aman32hhjbb/Ball-Beam-System/Balance_Ball_Beam_Report.pdf

## EE 396 Design Project Ball Beam System

Mohit Rana (200102054)
Aman Kumar (200102007)

Objective :

To design a control system for a ball and beam apparatus that can maintain the position of the ball at a specified location on the beam, despite of any change in the position of the ball along the beam.

Material Required :

1. Arduino Uno
2. Servo Motor
3. Two Ultrasonic Range Finder
4. Small Bread Board
5. Jumper Wire
6. Plywood
7. Plywood Paint
8. Pencil
9. Sandpaper
10. Hacksaw Blade
11. Ball
12. 9V Adapter

Introduction :

The ball and beam system is a classic example of a control system that is used to demonstrate various concepts in control theory. The system consists of a ball that rolls on an wooden beam, and a control mechanism that maintains the position of the ball at a specific location on the beam. The control mechanism can be implemented using various algorithms, including proportional, integral, derivative (PID) control.
In this project, we aimed to design and control a ball and beam system using a PID controller. The objective was to develop a system that could maintain the position of the ball at a specific location on the beam, despite disturbances or changes in the system parameters. We used a microcontroller, servo motor, ultrasonic sensors and other components to design the system.

Supervisor :
Prof. Chayan Bhawal

Physical Setup :

To create the physical ball beam system, we will utilize plywood as the primary material. The plywood pieces will be fastened together using nails to form permanent joints. The dimensions of the ball beam setup are illustrated in the accompanying figure.

1. The length of the beam on which the ball is resting is 45 cm. The width of top beam is less than the width of the lower beam. This ensures that that the top beam does not touch the bottom beam when it is at an inclined position.
2. Servo-motor is placed in such a way that the shaft connected to the top beam is almost at right-angles to ground when the beam is at balanced position.
3. The position of both the ultra-sonic sensors is set in such a way that that the transmitted waves from the sensor hits the center of the ball because wrong sensor placement can lead to erroneous readings which will make it difficult for us to tune the controller parameters.
4. To ensure the system operates smoothly and accurately, it is crucial to prevent any horizontal movement of the top beam. To achieve this, we will be using bearings to hold the spindle in place, while a pencil will be used as the spindle itself to prevent any horizontal movement of the top beam. We will fix the top beam firmly to the spindle to prevent unwanted vibrations that could interfere with tuning the controller parameters accurately. The combination of the bearing and pencil will ensure that the top beam is securely held in place, and we can expect the ball beam system to operate smoothly and accurately during our experiment.
5. To prevent the ball from colliding with the sensor, we will be installing a small barrier in front of the sensor. This barrier will ensure that the ball remains within the boundaries of the ball beam system and does not interfere with the accuracy of the sensor measurements.

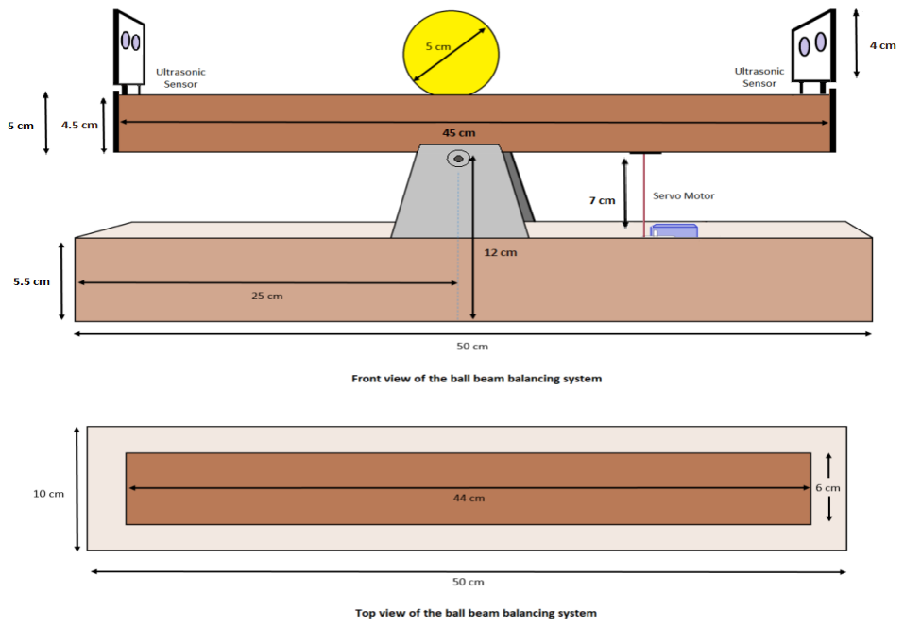
[picture p1: figure]

Modeling and Dynamics
The ball and beam system may be broken down into smaller systems, and when these systems work together, the ball appears to be moving smoothly on the beam and vice versa so knowing the contributions and coordination of each component becomes crucial from the perspective of mathematical analysis hence the system's equation of motion and transfer function must be developed from the perspective of control and the same is implemented below.

Transfer function of a Ball Beam System
The ratio of the output and input Laplace transforms is used to define the transfer function of any system. Newtonian mechanics can be used to get the equation for the motion of the ball on the beam. Combining the transfer functions of the following subsystems will yield the transfer function:
(i) Beam tilt to ball position
(ii) Input voltage of the motor to its angle of rotation and tilt angle of the beam. Think about Fig. 1 The ball on the beam is moving both in translation and in rotation. Now, assuming that the ball's translational acceleration is xሷand that force F is given by

Ftx= mxሷ= m

d

2x
dt²
, | (1)
Wℎere m is tℎe mass of tℎe Ball.

Tℎe rotational torque T of tℎe Ball = J

dw
dt
| Wℎere w is tℎe angular velocity.
J = Moment of Inertia of tℎe Ball

Rotaional Force Frx =

T
R

=

J
R²

xሷ

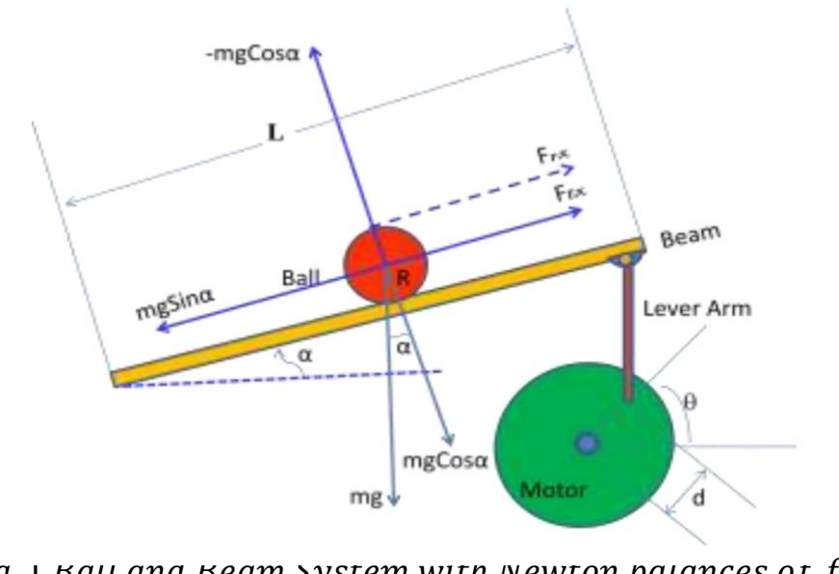
[picture p2: figure]

Fig. 1 Ball and Beam System witℎ Newton balances of forces

As shown in Fig. 1 we have Frx + Ftx = −mgsignα

J
R² + m xሷ= −mgsinα | (2)

The geometry of the lever arm section, as depicted in Fig. 2, can be used to determine the relationship between θ and α. The lever mechanism, which consists of lever arms SP = A and OS = d, is attached to the beam at P. Assume that the motor arm OS goes to T and the beam's end P moves to Q in such a way that ∠SOT = θ and ∠PO1Q = α.
OX = d cosθ; TX = dsinθ;
XS = OS − OX = d 1 − cosθ
O1M = L cosα; QM = L sinα; MP = L 1 − cosα TN = A sinβ; QN = A cosβ; MN = A cosβ − L sinα TX = PS − PG = MZ − MN
⇒ d sinθ = A − A cosβ + L sinα
⇒ d sinθ − A 1 − cosβ − L sinα = 0 ⇒ L sinα = d sinθ − A(1 − cos β) ⇒ α = arc sin d
L

sinθ −

A
L
1 − cosβ | (3)

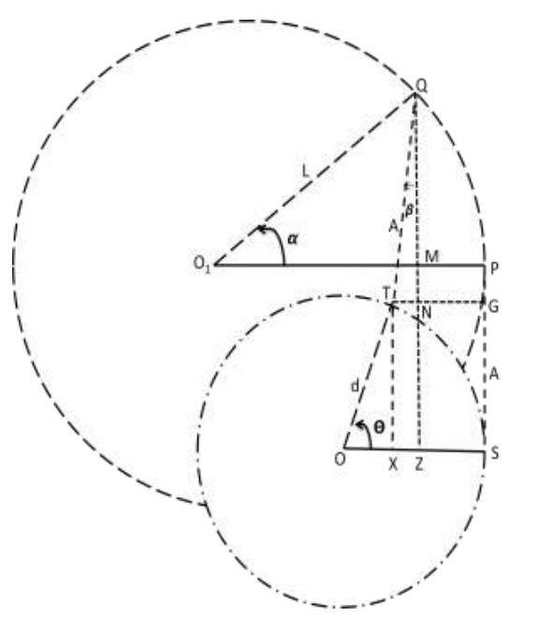
[picture p3: figure]

Fig. 2 Relation between Motor angle and Beam anle

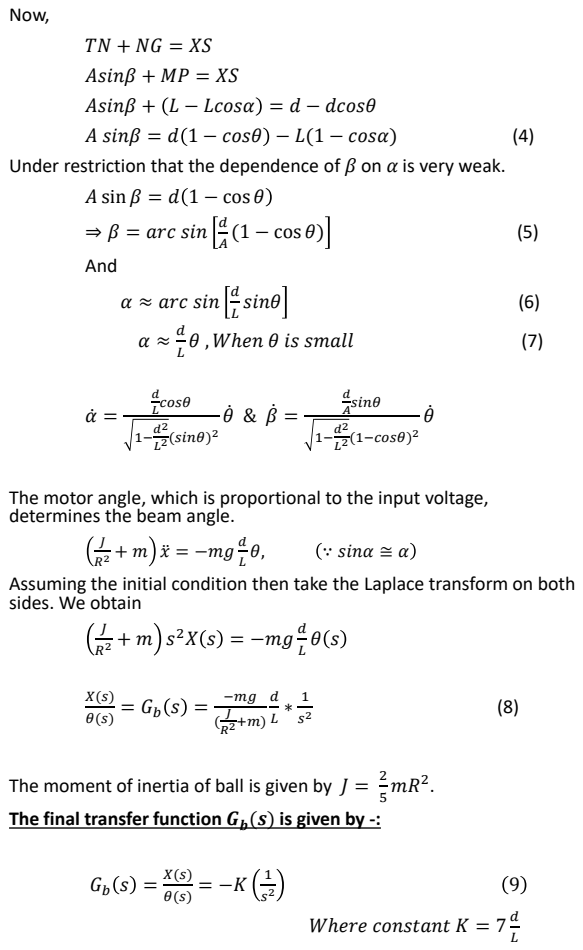
[picture p4: page 5]
Now,; A sinβ = d 1 − cosθ − L(1 − cosα); A sin β = d 1 − cos θ; ⇒ β = arc sin; (1 − cos θ); And; α ≈ arc sin; sinθ; θ , Wℎen θ is small; cosθ; (sinθ); (1−cosθ); ∵ sinα ≅ α; Wℎere constant K = 7

Asinβ + MP = XS
Asinβ + L − Lcosα = d − dcosθ

Under restriction that the dependence of β on α is very weak.

The motor angle, which is proportional to the input voltage,
determines the beam angle.

Assuming the initial condition then take the Laplace transform on both
sides. We obtain

The moment of inertia of ball is given by J =
The final transfer function Gb(s) is given by -:

Transfer Function of Servo Motor
The applied input voltage Ea(s) to the DC servomotor determines the angle of rotation of the motor. The motor is connected to the pivot of the beam which determines the tilt of the beam, which in turn regulates the velocity of the ball on the beam thus motor's transfer function Gm(s) is obtained as follows.
We have used DC servomotor whose armature controller is DC motor model. The armature current in the armature regulated DC motor which regulates the shaft position and speed while maintaining a constant field current.
Fig. 3 depicts the circuit diagram of an armature-controlled DC motor.

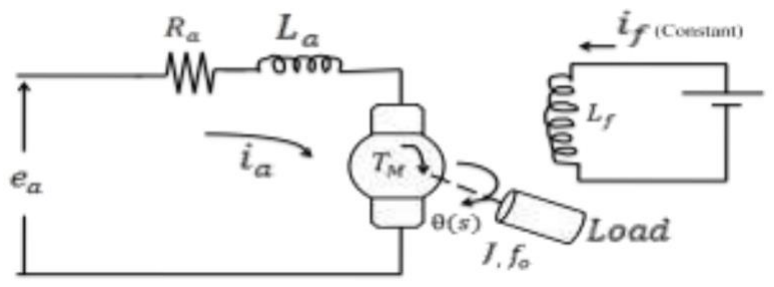
[picture p5: figure]

Fig. 3 Armature controlled DC Motor

The torque TM produced by the motor is proportional to the airgap flux φ and the armature current, and it can be determined by the applied armature voltage ea setup armature current ia in the armature circuit.

If we apply KVL in armature circuit gives we will get,

Here eb is the back emf generated by the armature's spin in the magnetic field.

where kb is the back e.m.f. constant

Parameters shown in the Fig.3.are, Ra = Resistance of armature
La = Inductance of armature
TM = Torque produced by motor (Nm )
θ = angular displacement of motor sℎaft

J = ( Jm + JL) =Equivalent moment of inertia of load and motor

f0= Viscous friction coefficent of motor and load acting on motor sℎaft

TM = k1 ∅ ia = k1kf if ia
= k1kfif ia = k1kfif ia = kTia where k1 = constant; kf = constant kT is tℎe motor constant

La

dia
dt + Raia + eb = ea (10)

eb = kb

dθ
dt
, | )11(

The motor's developed torque, denoted as TM, is utilized for rotating a load while resisting viscous forces. Hence, the torque equation can be expressed as follows:

J

d

2θ
dt² + f0

dθ
dt
= TM = kTia | 12

Taking initial condition to be zero and obtaining the Laplace transform of equation (10), (11) and (12), we get

(13)
Now, we used this equation to represent block diagram of motor as shown in Fig.4.

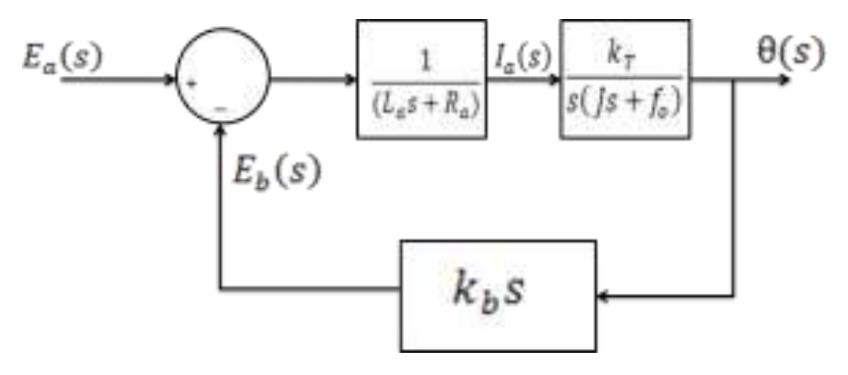
[picture p6: figure]

Fig. 4 TF of DC Motor
Putting dθ
dt

= ω = speed of motor

We get,

J

dω
dt

+ f0ω = kt

ia, | (14)

∴ ω s =

kTIa(s)
(Js+f0)

(15)

On integrating Ia s kT
(Js+f0)

, we will obtain mean position θ s of the shaft. Thus fig. 5 shows the modified version of fig. 4

La sIa (s) + Ra Ia (s) + Eb (s) = Ea (s) (La s + Ra )Ia (s) = Ea (s) − Eb (s)
Eb (s) = kb s θ(s)
( Js

2 + fo s)θ(s) = kT Ia (s)

Laplace transform gives us :-Jsω(s) + foω(s) = kTIa (s) ( Js + fo )ω(s) = kT Ia (s)

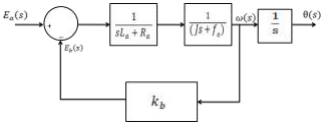
[picture p7: figure]

Fig.5 Modified block diagram of DC motor

The DC motor is an open loop system, yet the block diagram in Figure 5 includes a motor’s built-in feedback loop for the back e.m.f. However, this feedback is represented as electric friction, which is proportional to the negative rate of change of position θ(s) of the motor. This feedback mechanism enhances the stability of the motor. The transfer function of the overall block diagram in Figure 5 can be expressed as:

Gm s =

θ(s)
Ea s

=

kT
s

3jLa + Raj + foLa s

2 + foRas + kTkbs
Since La < 1,

Gm(s) =

kT
s(Rajs+foRa+kTkb)

Gm(s) =

kT
Ra
s(js+f)

(16)

wℎere f = πfo +

kTkb
Ra
Appearance of term kb in f = f0 +

ktkb
Ra

is known as electric friction.

Gm s =

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
s(τs+1)

Since kT = kb in MKS units.
The transfer function for the speed can be given by

wℎere km =

kT
Raf

= motor gain constant (17)

J
f

= τ = motor time constant

The parameters km and τ in the motor's block diagram represent the gain and time constants, respectively. These values depend on various motor parameters, including the armature resistance, back e.m.f. constant, and equivalent moment of inertia of the motor and load.
ω(s)
Ea(s)

=

km
(τs + 1) | (18)

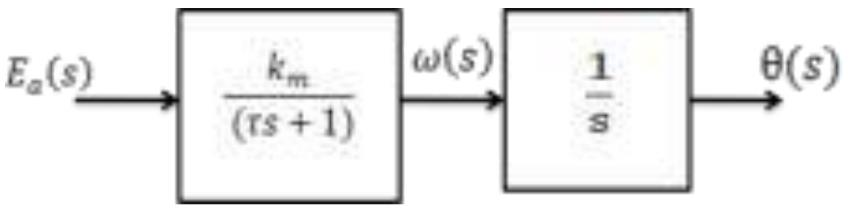
[picture p8: figure]

Fig. 6 Simplified block diagram of DC Motor

The block diagram clearly indicates that the DC motor acts as an integrating device in the servo system. It is coupled to the upper beam with the help of gear system and the output shaft.
By combining Gm s and GB s we get overall open loop transfer function as G s . Which is depicted in Fig.7.

Fig. 7 TF of Ball and Beam System

So the overall transfer function of the Ball Beam System (G(s)) :-G s = Gm s . GB s

G s =

X s
θ s
G s =

KmK
s

3 1+τs

Stability of this System without any controller

As indicated in Figure 8, the step response of this transfer function reveals that the system is unstable. When the beam is tilted, the ball rolls down due to the force of gravity and velocity depending upon tilt of the beam. To regulate motion of ball in beam we need to required a controller to stop fall down a ball as well position..

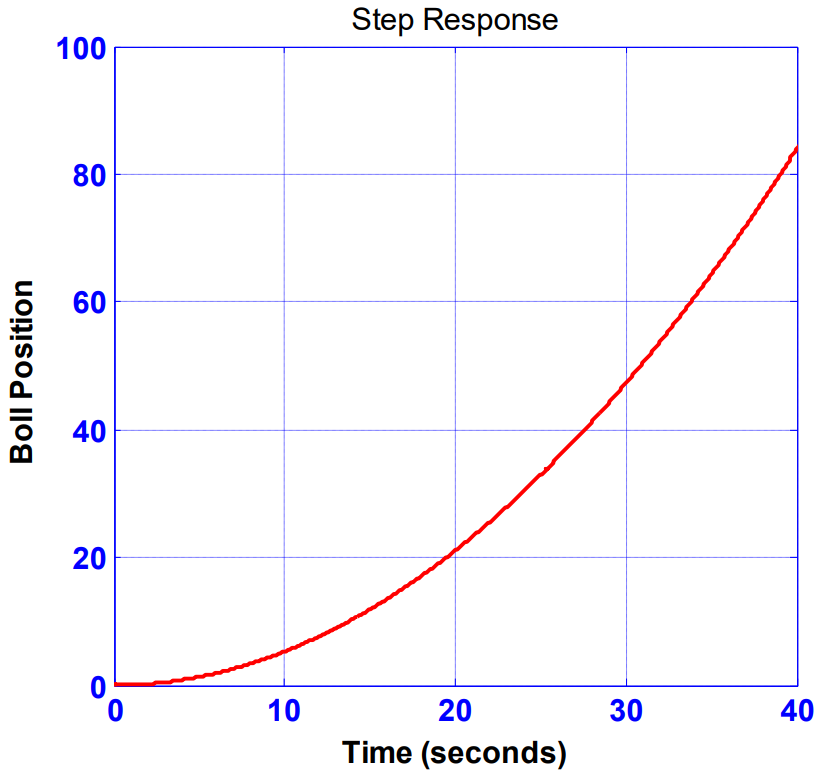
[picture p9: figure]

Fig.8 Step response.

ABOUT PID CONTROLLER

(PID) controller is a feedback control system that utilizes three distinct control actions. The system is combination of the proportional action, integral action, and derivative action to achieve stability in unstable systems.
To solve any PID control problem , the PID transfer function is represented in
Laplace transform as

PID = Kp +

Kt
s

+ Kds

Where
KP = Proportional gain
KI = Integral gain
KD = Derivative gain
The PID controller operates in a closed-loop system that involves various variables. One of the critical variables is the error (e), which represents the difference between the desired input value (R) and the actual output (Y). The error is fed back to the PID controller, which computes both the derivative and integral of the error. The controller's output signal (u) is calculated as the sum of the proportional gain (Kp) multiplied by the magnitude of the error, the integral gain (Ki) multiplied by the error, and the derivative gain (Kd) multiplied by the derivative of the error. This approach allows the PID controller to adjust the system's control signal based on the error's magnitude, rate of change, and duration

K + d ׬ K + pK =

de
dt

DESIGNING OF PID CONTROLLER AND ALGORITHM
We will be designing a PID controller for a ball beam balance system using an Arduino microcontroller. The PID controller will use the algorithm, given in Fig. , to adjust the angle of the beam in response to the position of the ball on the beam. We will program the Arduino with the algorithm and implement the PID controller on the hardware. We will also tune the PID parameters to achieve a stable and fast response of the ball on the beam, and test and refine the controller as needed. This showcase the capabilities of an Arduino microcontroller in control systems engineering and demonstrate the application of PID control to a real world system.
Control Loop Response | Rise Time | Overshoot | Settling Time | Steady-State Error
Kp | Decrease | Increase | Small Change | Decrease
Ki | Decrease | Increase | Increase | Eliminate
Kd | Small Change | Decrease | Decrease | Small Change

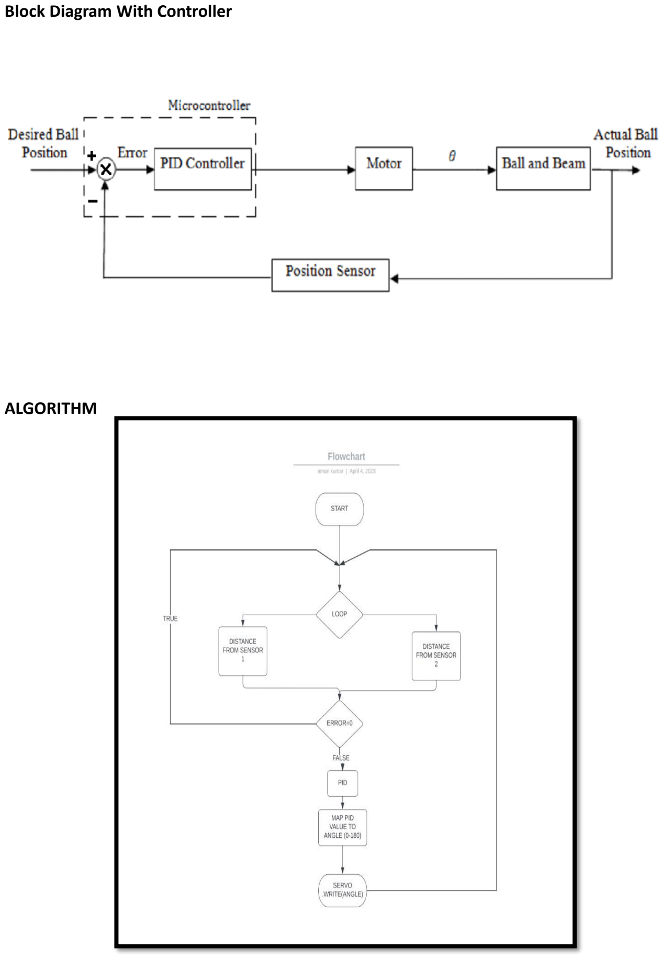
[picture p10: page 11]

Block Diagram With Controller

ALGORITHM

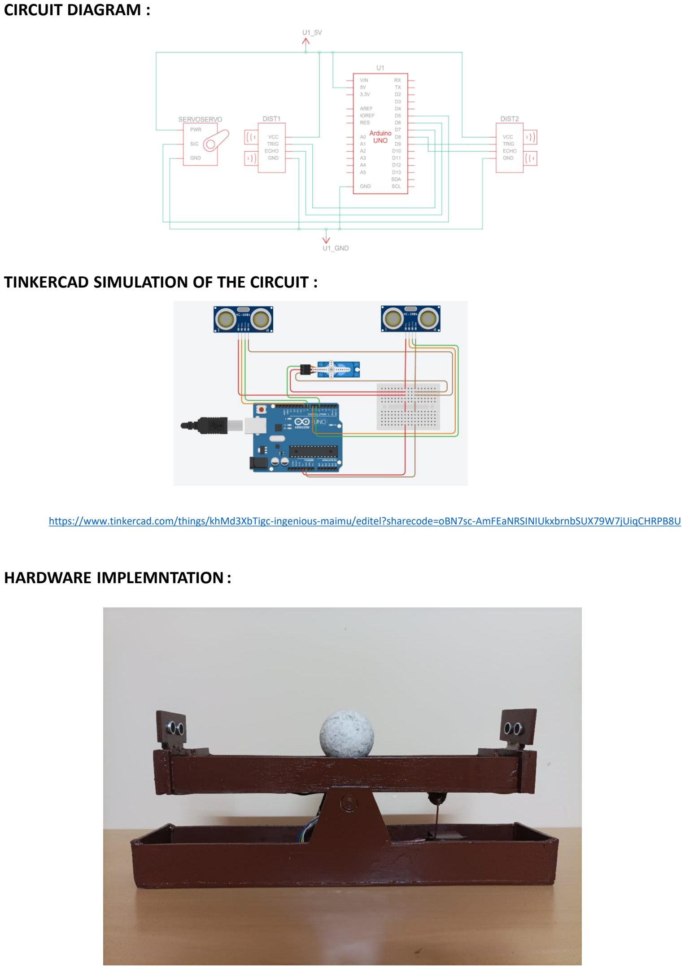
[picture p11: page 12]

CIRCUIT DIAGRAM :

TINKERCAD SIMULATION OF THE CIRCUIT :

https://www.tinkercad.com/things/khMd3XbTigc-ingenious-maimu/editel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

HARDWARE IMPLEMNTATION:

TUNING PID USING INPUT AND OUTPUT CHARACTERSTICS

Varying Kp keeping both Ki and Kd to zero.

At the correct value of Kp, the system response will be stable, fast, and free of oscillations or overshoot. The controller will be able to quickly and accurately respond to changes in the input or reference signal, bringing the output to the desired setpoint with minimal error.

Case 1: Kp=5, Kd=0, Ki=0

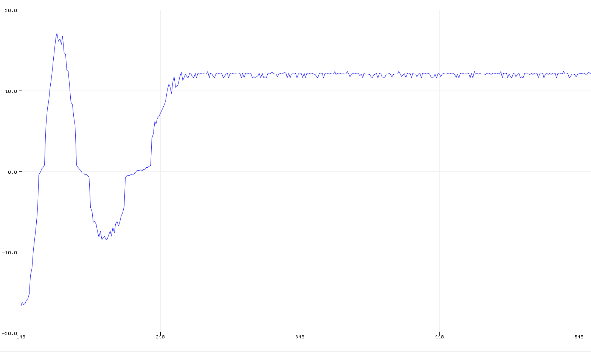
[picture p12: figure]

Case 2: Kp=15, Kd=0, Ki=0

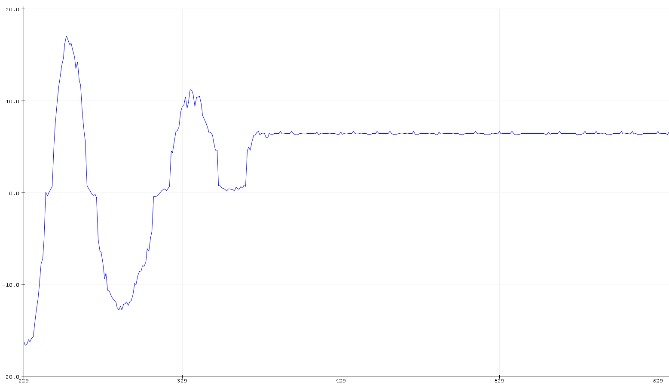
[picture p13: figure]

Case 3: Kp=35 ,Kd=0, Ki=0

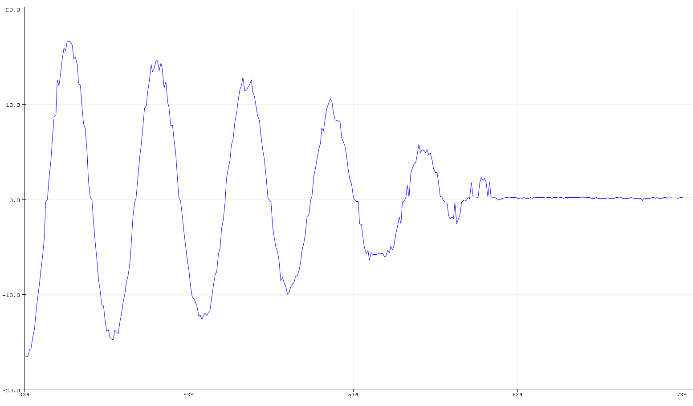
[picture p14: figure]
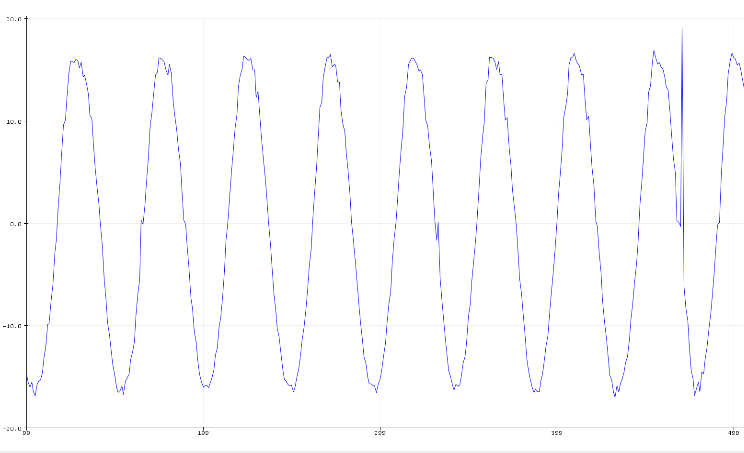
[picture p15: figure]

Case 4: Kp=55,Kd=0,Ki=0

The above condition has
been found to be true for
Kp = 35, therefore, it is
appropriate to set Kp to 35 in the system.

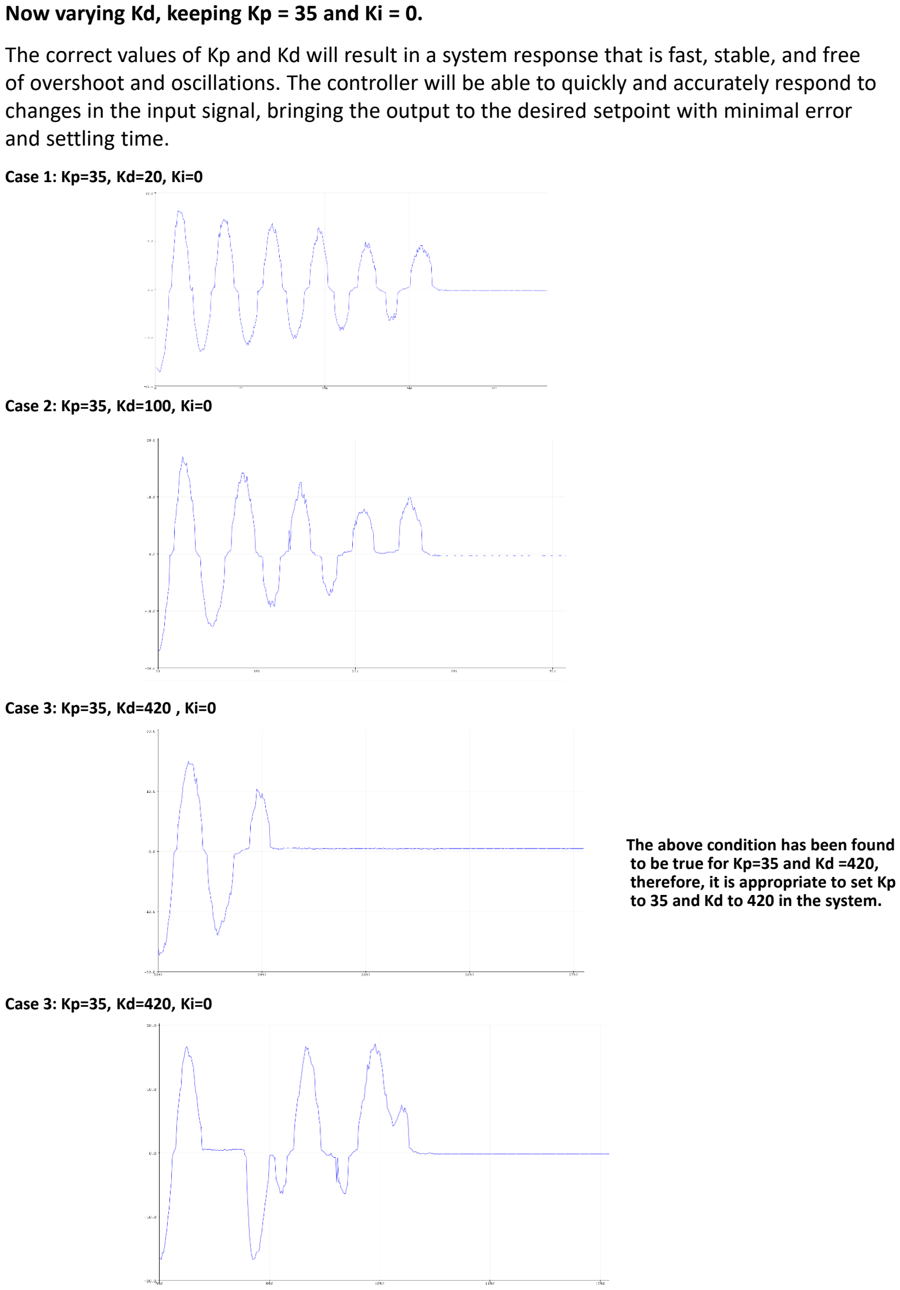
[picture p16: page 14]

Now varying Kd, keeping Kp = 35 and Ki = 0.

The correct values of Kp and Kd will result in a system response that is fast, stable, and free of overshoot and oscillations. The controller will be able to quickly and accurately respond to changes in the input signal, bringing the output to the desired setpoint with minimal error and settling time.

Case 1: Kp=35, Kd=20, Ki=0

Case 2: Kp=35, Kd=100, Ki=0

Case 3: Kp=35, Kd=420 , Ki=0

Case 3: Kp=35, Kd=420, Ki=0

The above condition has been found to be true for Kp=35 and Kd =420, therefore, it is appropriate to set Kp to 35 and Kd to 420 in the system.

Now varying Ki, keeping Kp = 35 and Kd = 420.

When all three gains are set correctly, the system should respond quickly to changes in the input signal, settle smoothly to the desired setpoint with minimal overshoot or oscillations, and maintain a stable output. The system should also be able to compensate for disturbances or changes in the input signal, and eliminate any steady-state error.

Case 1: Kp=35, Kd=420, Ki=0

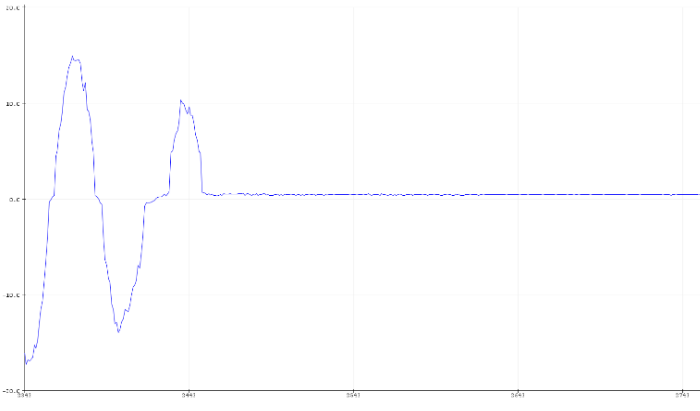
[picture p17: figure]

Case 2: Kp=35, Kd=420, Ki=0.015

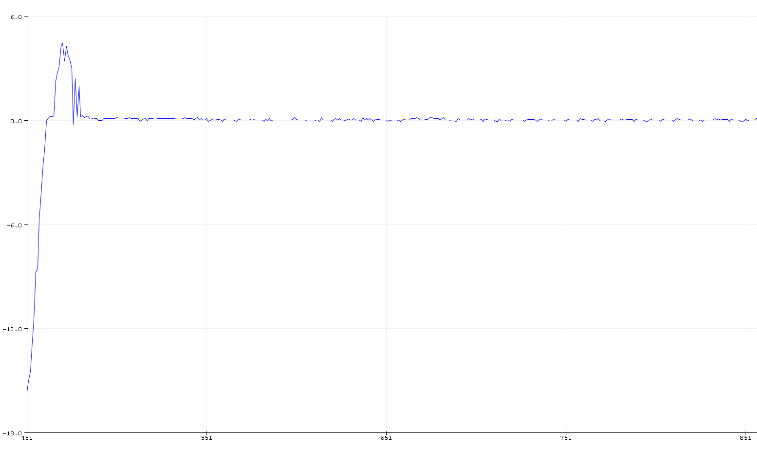
[picture p18: figure]

Case 3: Kp=35, Kd=420 , Ki=0

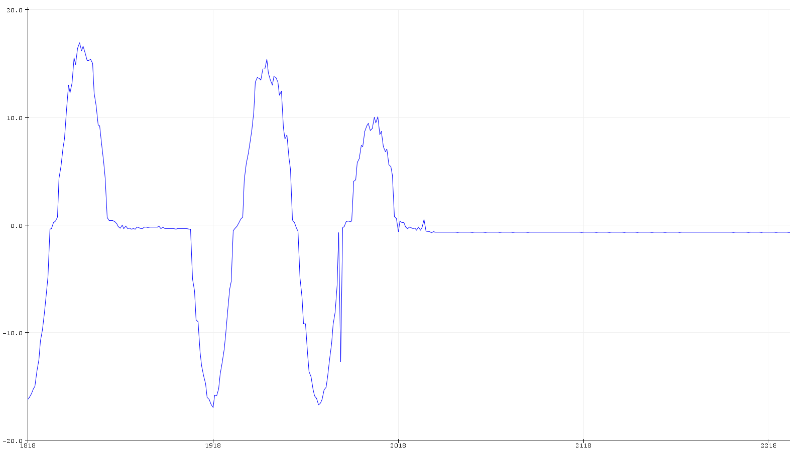
[picture p19: figure]

After several rounds of experimentation and analysis, we found that setting the proportional gain (Kp) to 35, the derivative gain (Kd) to 420, and the integral gain (Ki) to 0.015 produced the desired system behavior. These values were selected based on the specific characteristics of the system being controlled and were determined through a systematic tuning process.

The above condition has been found to be true for Kp=35, Kd=420 and Ki=0.015, therefore it is appropriate to set Kp to 35, Kd to 420 and Ki to 0.015 in the system.

OBTAINING CLOSED LOOP TRASFER FUNCTION OF THE CONTROLLED SYSTEM USING INPUT AND OUTPUT CHARATERSTICS

We obtained the transfer function of the system by taking input and respective output data from an Arduino microcontroller and using MATLAB for analysis.

To collect the data, we utilized Excel Data Streamer, which enabled us to stream real-time data from the Arduino to Excel. With the data in Excel, we were able to analyze the system response and derive the transfer function.
In MATLAB, we used the "tfest" function. This function estimates the transfer function of a system based on input/output data in the time or frequency domain.

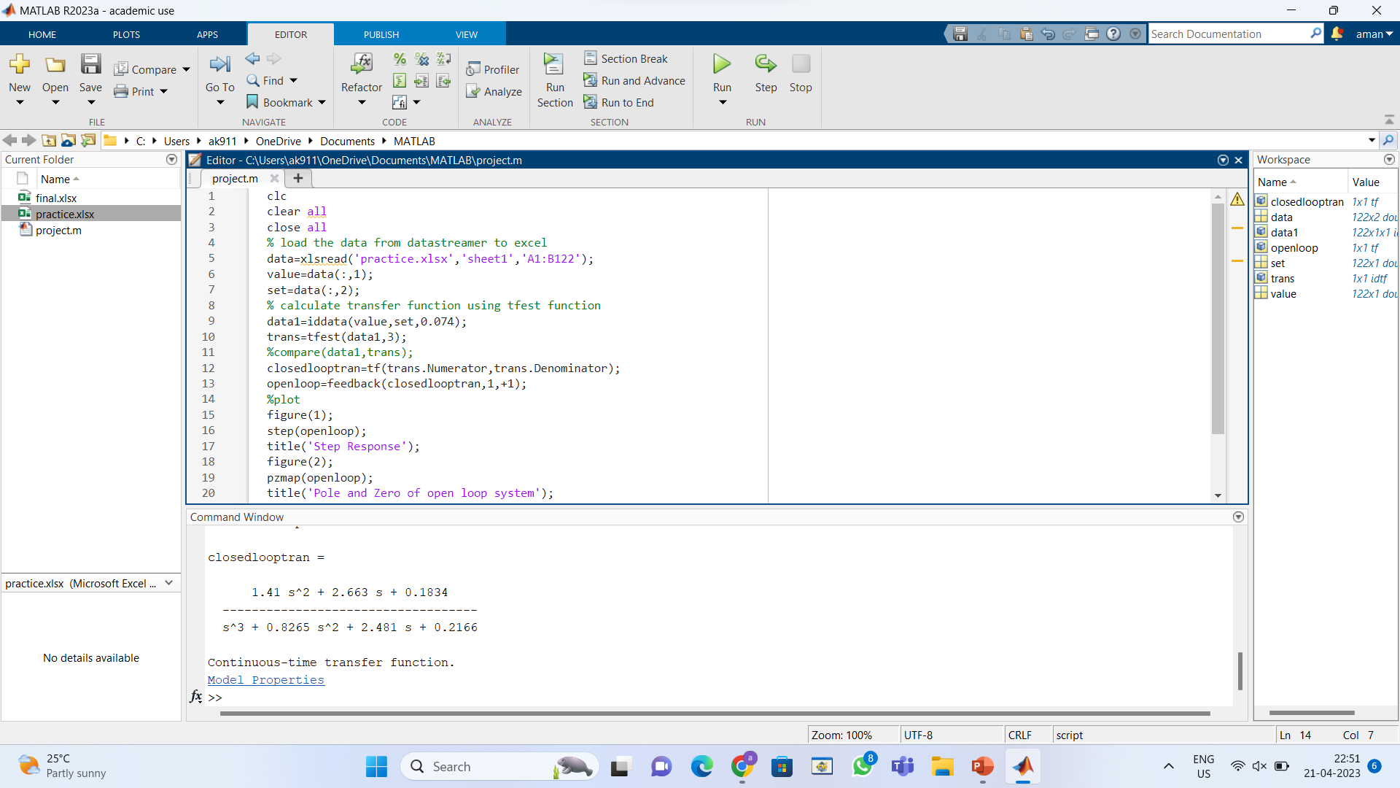
[picture p20: figure]

T s =

1.41s²+2.66s+0.1834
s

3+0.8265s

2+2.481s+0.2166

Poles are at (-0.37+1.5j), (-0.37-1.5j), (-0.089+0j).
Since all four poles of the transfer function are located on the left-hand side of the complex plane, we can conclude that the system is stable. This property ensures that the system will respond to inputs in a predictable and reliable manner, without exhibiting oscillatory or unstable behavior.

We can verify this from the pole zero location of the Transfer Function.

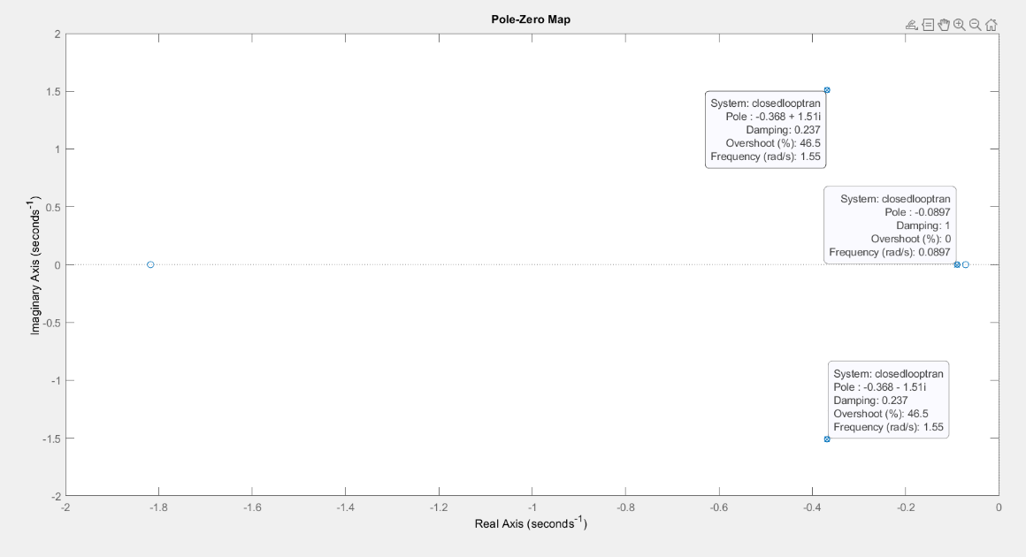
[picture p21: figure]

OBSERVATIONS :

When changing the values of Kp, Ki, and Kd in a ball beam system, we can observe different behaviors in the system's response. Specifically:
Changing Kp: Increasing Kp can make the system more responsive and decrease its settling time, but it can also increase overshoot and oscillations. Decreasing Kp can make the system less responsive and increase its settling time, but it can also decrease overshoot and oscillations.
Changing Ki: Increasing Ki can help to correct any steady-state error in the system, but it can also increase overshoot and oscillations. Decreasing Ki can reduce overshoot and oscillations, but it can also increase settling time and make the system less responsive.
Changing Kd: Increasing Kd can help to dampen out any overshoot or oscillations in the system, but it can also increase settling time and make the system less responsive. Decreasing Kd can decrease settling time and make the system more responsive, but it can also increase overshoot and oscillations.
By observing the system's response to changes in Kp, Ki, and Kd, we can determine the optimal values of these parameters to achieve the desired performance of the ball beam system. This process involves testing the system with different parameter values, evaluating the system's response, and adjusting the parameters until the desired
performance is achieved.

CONCLUSION :

The ball and beam system's mathematical model was formulated by applying both physical and electrical principles, and then simplified according to its relevant parameters.

The parameters (Kp, Ki, and Kd) were determined through manual tuning from the ball beam system model to achieve optimal system response. Experimental results revealed that the best controller parameters for the system were Kp =35, Ki=0.015, and Kd=420.The system's accuracy was evaluated by testing its ability to track the ball's position at three different locations, and it was discovered that altering the set point did not have any impact on the accuracy.

CHALLENGES FACED :

### 1. Vibrations at the Joint : The first challenge that we encountered was to prevent

horizontal movement of the upper beam and minimize vibrations at the joints, so we used pencil as a spindle with a bearing inside a plywood to create a fixed joint for a ball beam system that was experiencing vibration issues. This helped to improve stability and precision by reducing friction and wear on the joint.

### 2. Height of the sensor : To obtain accurate measurements of the distance between the

ball and the beam, it was necessary to position the ultrasonic sensor at a specific height such that it points directly at the center of the ball. To address this challenge, we designed a holder for the sensor that allows for the height to be adjusted as needed to ensure precise alignment with the ball.

### 3. Incorrect Readings of the Sensor : To address the issue of an ultrasonic sensor giving

incorrect readings after 20 cm, we used two ultrasonic sensors in a binary format. This involves using one sensor to detect the distance up to 20 cm, and the second sensor to detect distances beyond 20 cm. By combining the readings from the two sensors, we obtained a more accurate measurement of the distance.

### 4. Loose Gear : The gear joint in the servo motor is loose, preventing the motor from

attaining a fixed position and causing errors in the angle of tilt of the beam. This looseness is a property of the motor's manufacturing and cannot be removed.

### 5. Placement of Motor : One challenge we faced was determining the optimal placement

of the motor in relation to the joint. Fixing the motor too close to the joint resulted in increased moment, but also introduced unwanted vibrations into the system. On the other hand, fixing the motor too far from the joint helped reduce vibrations, but limited the range of movement. To overcome this challenge, we carefully experimented with different motor placements to find the right balance between moment and vibration.

### 6. PID Tuning : The final challenge we encountered was in tuning the PID parameters for

the system. Achieving optimal PID tuning can be challenging due to the complex interaction between the proportional, integral, and derivative gains, and their effects on the system's response. Finding the right balance among these parameters to achieve the desired system behavior, such as fast response time, minimal overshoot, and stable oscillation, can be challenging and may require multiple iterations and adjustments. However, with thorough experimentation and analysis of the system's input-output response, we were able to successfully tune the PID parameters to achieve satisfactory system performance.

MAJOR LEARNINGS :

### 1. Using Carpentry Instruments : We learned how to use various carpentry tools and

techniques during the development of our ball-beam balance project, as we used wooden ply as our primary material for the mechanical model. This included the use of saws, drills, nails, sandpaper, rulers, measuring tapes, levels, and clamps. Proper tool maintenance and safety were also emphasized throughout the project.

### 2. How to remove unwanted vibrations and movements in the system : We learned

that unwanted movement in the upper beam and vibrations at the joints could introduce errors in our ball-beam system. To prevent this, we used a pencil as a spindle with a bearing inside a plywood to create a fixed joint for the ball-beam system. This helped to minimize vibrations and reduce friction, improving stability and precision in the system. Overall, this experience taught us the importance of identifying and addressing sources of unwanted movement and vibrations in mechanical systems. By implementing solutions such as bearings and spindles, we can improve the accuracy and reliability of our systems.

### 3. How to obtain correct reading from sensors : To address the challenge of obtaining

accurate readings from the ultrasonic sensor, we visualized the sensor's output using the serial plotter. This helped us to identify and address any irregularities in the readings caused by rapid changes in distance. By adjusting the sensor's parameters (height) based on real-time data analysis, we were able to obtain more reliable and accurate readings. This experience taught us the importance of real-time data analysis and visualization in sensor-based projects.
4. How to obtain sufficient friction in real objects : To maintain the balance of our ball-beam system, we roughened the surface of both the ball and beam using Hacksaw blade to increase friction. Through experimentation, we found that a slightly rough surface helped to stabilize the system and prevent excessive movement, but too much friction could cause the ball to stick and impede its movement. Overall, we gained valuable knowledge and experience in maintaining and controlling friction in real-world applications.

### 5. Experimental Tuning PID Controller : To tune the PID parameters for our ball-beam

system, we experimented with different values of proportional, integral, and derivative gains. We adjusted the PID parameters multiple times by analyzing the system's input-output response until we achieved the desired behavior. This experience taught us patience, attention to detail, and a better understanding of how to apply control theory in practice.
